ttkpark/BLE_LED_Dongle/BLE_LED_Dongle/placement/BLE_LED_Dongle_BOM.xlsx

Value | Reference | LCSC | Footprint
3.7V | BT1 | C295747 | Connector_JST:JST_PH_S2B-PH-K_1x02_P2.00mm_Horizontal
12p | C1,C2,C3,C4 | C76948 | Capacitor_SMD:C_0402_1005Metric
100n | C5,C8,C9,C15 | C1525 | Capacitor_SMD:C_0402_1005Metric
100p | C6 | C26409 | Capacitor_SMD:C_0402_1005Metric
1u | C7,C12,C14 | C14445 | Capacitor_SMD:C_0402_1005Metric
4u7 | C10 | C23733 | Capacitor_SMD:C_0402_1005Metric
0.8p | C11 | C327032 | Capacitor_SMD:C_0402_1005Metric
22n | C13 | C337699 | Capacitor_SMD:C_0402_1005Metric
47u | C16,C17 | C68361 | Capacitor_SMD:C_1206_3216Metric
WS2812B-2020 | D1,D2,D3,D4,D5,D6,D7,D8,D9,D10,D11,D12,D13,D14,D15,D16,D17,D18,D19,D20,D21,D22,D23,D24,D25,D26,D27,D28,D29,D30,D31,D32,D33,D34,D35,D36,D37,D38,D39,D40,D41,D42,D43,D44,D45,D46,D47,D48,D49,D50,D51,D52,D53,D54,D55,D56,D57,D58,D59,D60,D61,D62,D63,D64,D65,D66,D67,D68,D69,D70,D71,D72,D73,D74,D75,D76,D77,D78,D79,D80,D81,D82,D83,D84,D85,D86,D87,D88,D89,D90,D91,D92,D93,D94,D95,D96,D97,D98,D99,D100,D101,D102,D103,D104,D105,D106,D107,D108,D109,D110,D111,D112,D113,D114,D115,D116,D117,D118,D119,D120,D121,D122,D123,D124,D125,D126,D127,D128,D129,D130,D131,D132,D133,D134,D135,D136,D137,D138,D139,D140,D141,D142,D143,D144 | C965555 | LED_SMD:LED_WS2812B-2020_PLCC4_2.0x2.0mm
Charge | D145 | C19171390 | LED_SMD:LED_0603_1608Metric
Standby | D146 | C22371297 | LED_SMD:LED_0603_1608Metric
Conn_01x04 | J1 | C492412 | Connector_PinHeader_2.54mm:PinHeader_1x04_P2.54mm_Horizontal
Conn_02x08_Counter_Clockwise | J2 |  | Connector_PinHeader_2.54mm:PinHeader_2x08_P2.54mm_Vertical
USB_C_Receptacle_PowerOnly_6P | J3 | C668623 | Connector_USB:USB_C_Receptacle_GCT_USB4125-xx-x-0190_6P_TopMnt_Horizontal
3n9 | L1 | C98062 | Inductor_SMD:L_0402_1005Metric
1u | L2 | C5343973 | Inductor_SMD:L_6.3x6.3_H3
1K5 | R1,R5,R6,R7,R10 | C22843 | Resistor_SMD:R_0603_1608Metric
5K1 | R2,R3 | C23186 | Resistor_SMD:R_0603_1608Metric
11K | R4 | C2906986 | Resistor_SMD:R_0603_1608Metric
SW_SPDT | SW1 | C431547 | SK12D07VG4NSPA_CNK
nRF52810-QCxx | U1 | C519278 | Package_DFN_QFN:QFN-32-1EP_5x5mm_P0.5mm_EP3.6x3.6mm
TPS61023DRLR | U2 | C919459 | DRL0006A
TP4056-42-ESOP8 | U3 | C382139 | Package_SO:SOIC-8-1EP_3.9x4.9mm_P1.27mm_EP2.41x3.3mm_ThermalVias
XC6206PxxxMR | U4 | C5446 | Package_TO_SOT_SMD:SOT-23-3
Crystal | Y1 | C97606 | Crystal:Crystal_SMD_3215-2Pin_3.2x1.5mm
Crystal_GND23 | Y2 | C2965582 | Crystal:Crystal_SMD_2016-4Pin_2.0x1.6mm
