ttkpark/BLE_LED_Dongle/BLE_LED_Dongle/BLE_LED_Dongle.kicad_pcb

## KiCad design BLE_LED_Dongle/BLE_LED_Dongle.kicad_pcb (2026-02-08)

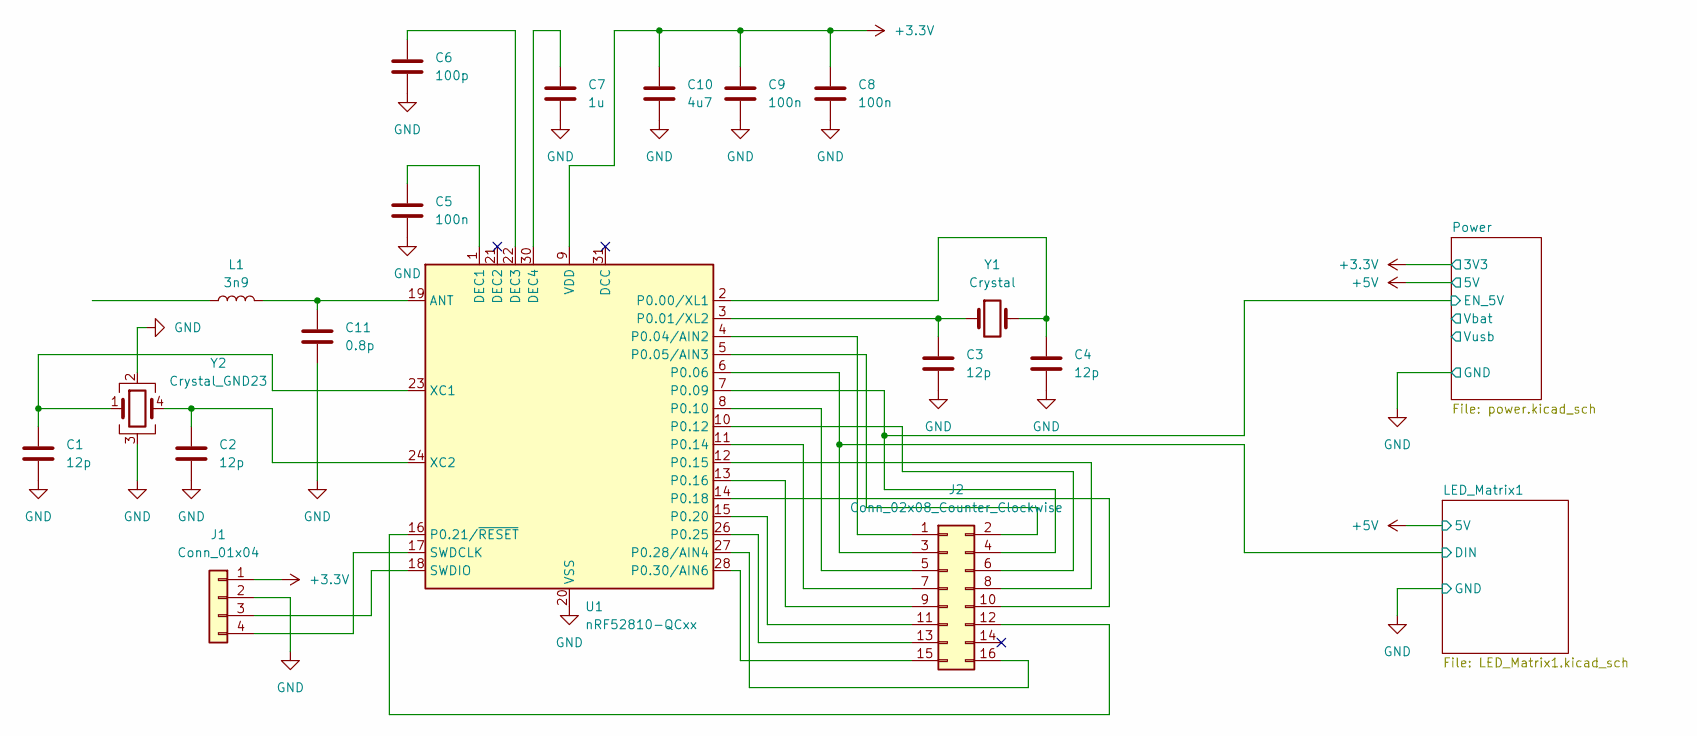
[picture p1: schematic BLE_LED_Dongle.kicad_sch]

Parts:
C1, C2, C3, C4: 12p; C_0402_1005Metric; LCSC C76948
C5, C8, C9: 100n; C_0402_1005Metric; LCSC C1525
C6: 100p; C_0402_1005Metric; LCSC C26409
C7: 1u; C_0402_1005Metric; LCSC C14445
C10: 4u7; C_0402_1005Metric; LCSC C23733
C11: 0.8p; C_0402_1005Metric; LCSC C327032
J1: Conn_01x04; PinHeader_1x04_P2.54mm_Horizontal; LCSC C492412
J2: Conn_02x08_Counter_Clockwise; PinHeader_2x08_P2.54mm_Vertical
L1: 3n9; L_0402_1005Metric; LCSC C98062
U1: nRF52810-QCxx; QFN-32-1EP_5x5mm_P0.5mm_EP3.6x3.6mm; LCSC C519278
Y1: Crystal; Crystal_SMD_3215-2Pin_3.2x1.5mm; LCSC C97606
Y2: Crystal_GND23; Crystal_SMD_2016-4Pin_2.0x1.6mm; LCSC C2965582

Connections:
+3.3V: C8.1, C9.1, C10.1, J1.1, U1.9 (VDD), U1.25 (VDD), U1.32 (VDD); also elsewhere on the board
/LED_Matrix1/DIN: J2.3 (Pin_2), U1.6 (P0.06); also elsewhere on the board
/Power/EN_5V: J2.4 (Pin_15), U1.7 (P0.09); also elsewhere on the board
GND: C1.2, C2.2, C3.2, C4.2, C5.2, C6.2, C7.2, C8.2, C9.2, C10.2, C11.2, J1.2, U1.20 (VSS), U1.29 (VSS), U1.33 (VSS), Y2.2, Y2.3; also elsewhere on the board
unnamed: J1.3, U1.18 (SWDIO)
unnamed: J1.4, U1.17 (SWDCLK)
unnamed: J2.1, U1.4 (P0.04/AIN2)
unnamed: J2.5 (Pin_3), U1.8 (P0.10)
unnamed: J2.7 (Pin_4), U1.11 (P0.14)
unnamed: J2.9 (Pin_5), U1.13 (P0.16)
unnamed: J2.11 (Pin_6), U1.15 (P0.20)
unnamed: J2.13 (Pin_7), U1.26 (P0.25)
unnamed: J2.15 (Pin_8), U1.28 (P0.30/AIN6)
unnamed: J2.12 (Pin_11), U1.16 (P0.21/~RESET)
unnamed: J2.10 (Pin_12), U1.14 (P0.18)
unnamed: J2.8 (Pin_13), U1.12 (P0.15)
unnamed: J2.6 (Pin_14), U1.10 (P0.12)
unnamed: J2.2 (Pin_16), U1.5 (P0.05/AIN3)
unnamed: C11.1, L1.2, U1.19 (ANT)
unnamed: C5.1, U1.1 (DEC1)
unnamed: C6.1, U1.22 (DEC3)
unnamed: C7.1, U1.30 (DEC4)
unnamed: C4.1, U1.2 (P0.00/XL1), Y1.2
unnamed: C3.1, U1.3 (P0.01/XL2), Y1.1
unnamed: J2.16, U1.27 (P0.28/AIN4)
unnamed: C1.1, U1.23 (XC1), Y2.1
unnamed: C2.1, U1.24 (XC2), Y2.4

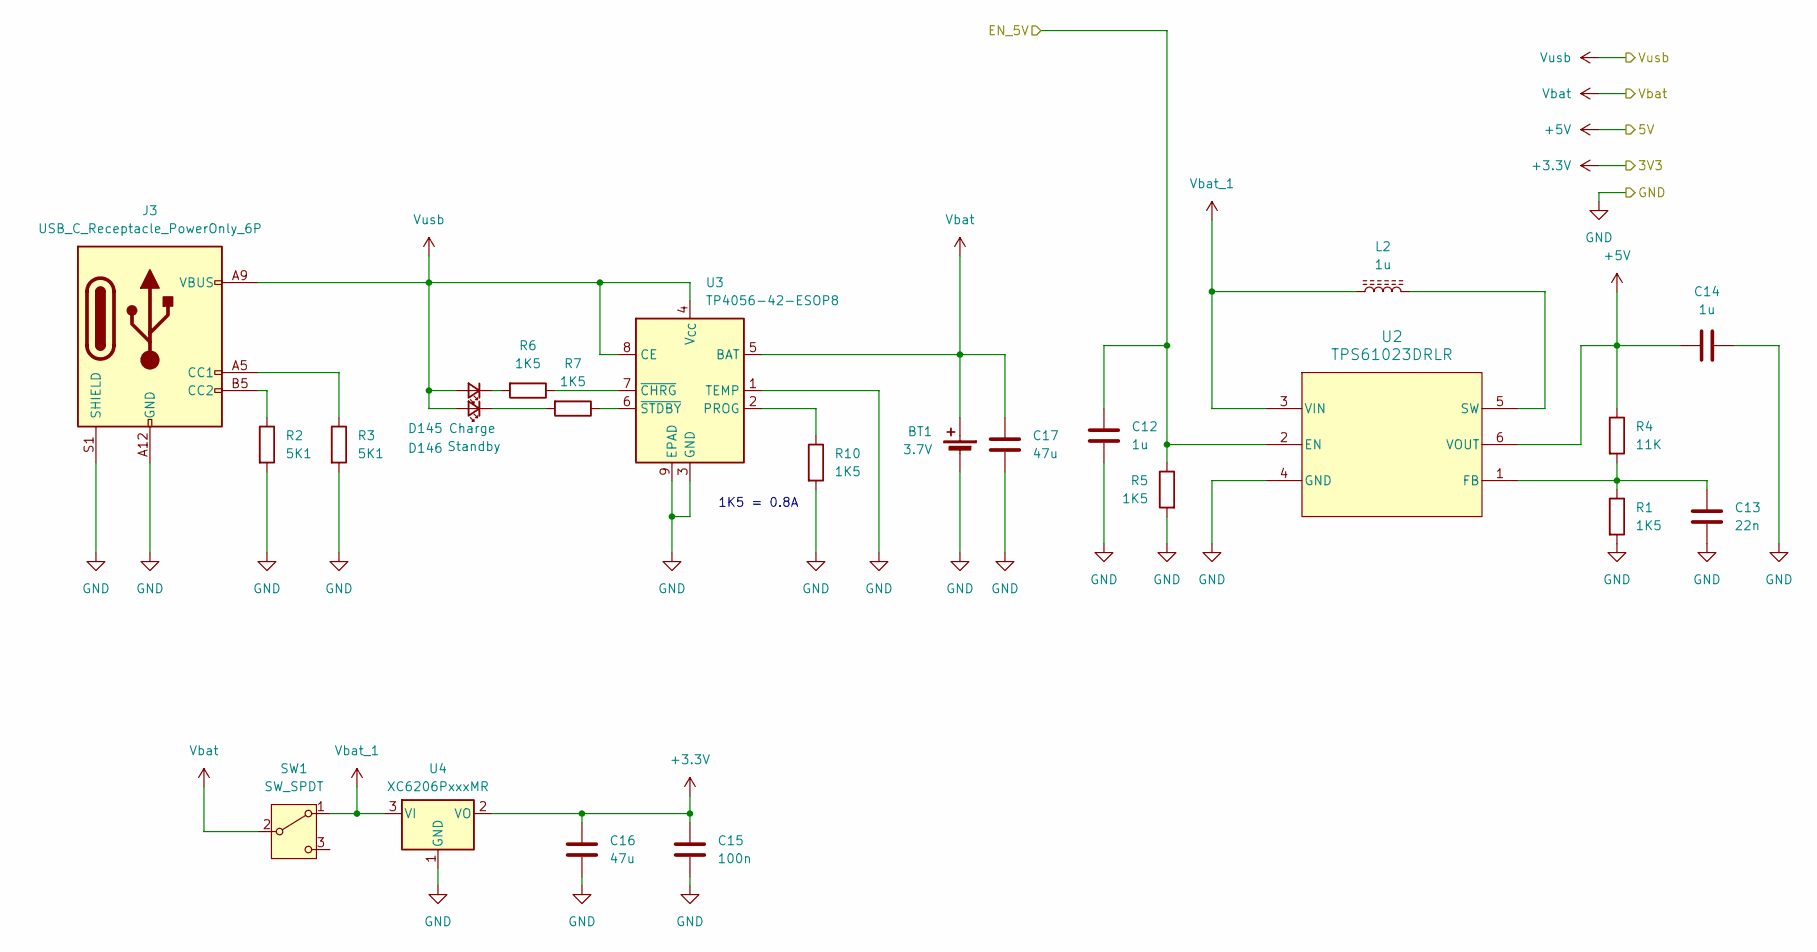
[picture p2: schematic power.kicad_sch]

Parts:
BT1: 3.7V; JST_PH_S2B-PH-K_1x02_P2.00mm_Horizontal; LCSC C295747
C12, C14: 1u; C_0402_1005Metric; LCSC C14445
C13: 22n; C_0402_1005Metric; LCSC C337699
C15: 100n; C_0402_1005Metric; LCSC C1525
C16, C17: 47u; C_1206_3216Metric; LCSC C68361
D145: Charge; LED_0603_1608Metric; LCSC C19171390
D146: Standby; LED_0603_1608Metric; LCSC C22371297
J3: USB_C_Receptacle_PowerOnly_6P; USB_C_Receptacle_GCT_USB4125-xx-x-0190_6P_TopMnt_Horizontal; LCSC C668623
L2: 1u; L_6.3x6.3_H3; LCSC C5343973
R1, R5, R6, R7, R10: 1K5; R_0603_1608Metric; LCSC C22843
R2, R3: 5K1; R_0603_1608Metric; LCSC C23186
R4: 11K; R_0603_1608Metric; LCSC C2906986
SW1: SW_SPDT; SK12D07VG4NSPA_CNK; LCSC C431547
U2: TPS61023DRLR; DRL0006A; LCSC C919459
U3: TP4056-42-ESOP8; SOIC-8-1EP_3.9x4.9mm_P1.27mm_EP2.41x3.3mm_ThermalVias; LCSC C382139
U4: XC6206PxxxMR; SOT-23-3; LCSC C5446

Connections:
+3.3V: C15.2, C16.2, U4.2 (VO); also elsewhere on the board
+5V: C14.1, R4.1, U2.6 (VOUT); also elsewhere on the board
/Power/EN_5V: C12.1, R5.1, U2.2 (EN); also elsewhere on the board
GND: BT1.2 (-), C12.2, C13.2, C14.2, C15.1, C16.1, C17.1, J3.A12 (GND), J3.B12 (GND), J3.S1 (SHIELD), R1.2, R2.2, R3.2, R5.2, R10.2, U2.4 (GND), U3.1 (TEMP), U3.3 (GND), U3.9 (EPAD), U4.1 (GND); also elsewhere on the board
unnamed: D145.1 (K), R6.2
unnamed: D146.1 (K), R7.2
unnamed: J3.A5 (CC1), R3.1
unnamed: J3.B5 (CC2), R2.1
unnamed: C13.1, R1.1, R4.2, U2.1 (FB)
unnamed: L2.2, U2.5 (SW)
unnamed: R10.1, U3.2 (PROG)
unnamed: R6.1, U3.7 (~CHRG)
unnamed: R7.1, U3.6 (~STDBY)
Vbat: BT1.1 (+), C17.2, SW1.2 (B), U3.5 (BAT)
Vbat_1: L2.1, SW1.1 (A), U2.3 (VIN), U4.3 (VI)
Vusb: D145.2 (A), D146.2 (A), J3.A9 (VBUS), J3.B9 (VBUS), U3.4 (V_{CC}), U3.8 (CE)

Notes on the sheet:
1K5 = 0.8A

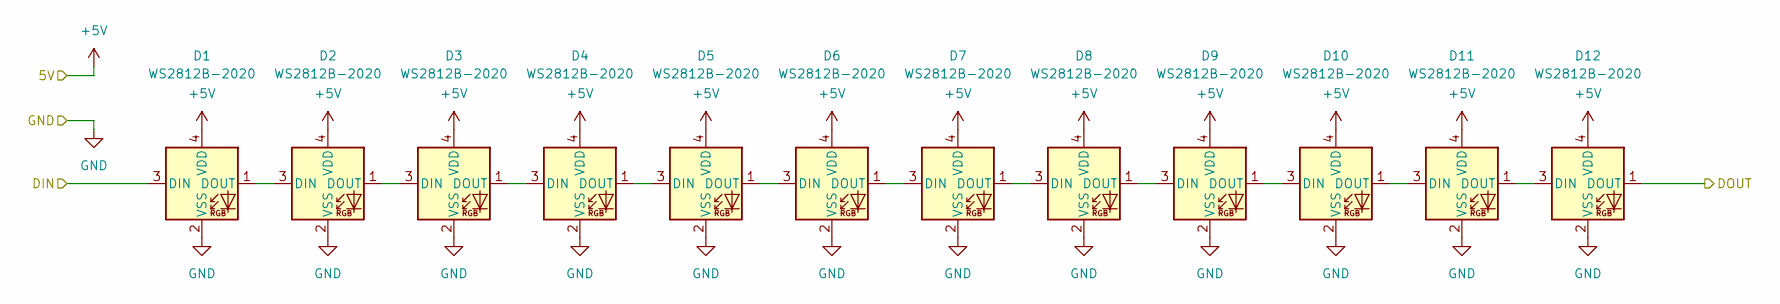
[picture p3: schematic led_matrix.kicad_sch]

Parts:
D1, D2, D3, D4, D5, D6, D7, D8, D9, D10, D11, D12: WS2812B-2020; LED_WS2812B-2020_PLCC4_2.0x2.0mm; LCSC C965555

Connections:
+5V: D1.4 (VDD), D2.4 (VDD), D3.4 (VDD), D4.4 (VDD), D5.4 (VDD), D6.4 (VDD), D7.4 (VDD), D8.4 (VDD), D9.4 (VDD), D10.4 (VDD), D11.4 (VDD), D12.4 (VDD); also elsewhere on the board
/LED_Matrix1/DIN: D1.3 (DIN); also elsewhere on the board
/LED_Matrix1/LED_Matrix_Line0/DOUT: D12.1 (DOUT); also elsewhere on the board
GND: D1.2 (VSS), D2.2 (VSS), D3.2 (VSS), D4.2 (VSS), D5.2 (VSS), D6.2 (VSS), D7.2 (VSS), D8.2 (VSS), D9.2 (VSS), D10.2 (VSS), D11.2 (VSS), D12.2 (VSS); also elsewhere on the board
unnamed: D1.1 (DOUT), D2.3 (DIN)
unnamed: D2.1 (DOUT), D3.3 (DIN)
unnamed: D3.1 (DOUT), D4.3 (DIN)
unnamed: D4.1 (DOUT), D5.3 (DIN)
unnamed: D5.1 (DOUT), D6.3 (DIN)
unnamed: D6.1 (DOUT), D7.3 (DIN)
unnamed: D7.1 (DOUT), D8.3 (DIN)
unnamed: D8.1 (DOUT), D9.3 (DIN)
unnamed: D9.1 (DOUT), D10.3 (DIN)
unnamed: D10.1 (DOUT), D11.3 (DIN)
unnamed: D11.1 (DOUT), D12.3 (DIN)

Parts of its further copies:
D13, D14, D15, D16, D17, D18, D19, D20, D21, D22, D23, D24, D25, D26, D27, D28, D29, D30, D31, D32, D33, D34, D35, D36, D37, D38, D39, D40, D41, D42, D43, D44, D45, D46, D47, D48, D49, D50, D51, D52, D53, D54, D55, D56, D57, D58, D59, D60, D61, D62, D63, D64, D65, D66, D67, D68, D69, D70, D71, D72, D73, D74, D75, D76, D77, D78, D79, D80, D81, D82, D83, D84, D85, D86, D87, D88, D89, D90, D91, D92, D93, D94, D95, D96, D97, D98, D99, D100, D101, D102, D103, D104, D105, D106, D107, D108, D109, D110, D111, D112, D113, D114, D115, D116, D117, D118, D119, D120, D121, D122, D123, D124, D125, D126, D127, D128, D129, D130, D131, D132, D133, D134, D135, D136, D137, D138, D139, D140, D141, D142, D143, D144: WS2812B-2020; LED_WS2812B-2020_PLCC4_2.0x2.0mm; LCSC C965555

Connections of its further copies:
+5V: D13.4 (VDD), D14.4 (VDD), D15.4 (VDD), D16.4 (VDD), D17.4 (VDD), D18.4 (VDD), D19.4 (VDD), D20.4 (VDD), D21.4 (VDD), D22.4 (VDD), D23.4 (VDD), D24.4 (VDD), D25.4 (VDD), D26.4 (VDD), D27.4 (VDD), D28.4 (VDD), D29.4 (VDD), D30.4 (VDD), D31.4 (VDD), D32.4 (VDD), D33.4 (VDD), D34.4 (VDD), D35.4 (VDD), D36.4 (VDD), D37.4 (VDD), D38.4 (VDD), D39.4 (VDD), D40.4 (VDD), D41.4 (VDD), D42.4 (VDD), D43.4 (VDD), D44.4 (VDD), D45.4 (VDD), D46.4 (VDD), D47.4 (VDD), D48.4 (VDD), D49.4 (VDD), D50.4 (VDD), D51.4 (VDD), D52.4 (VDD), D53.4 (VDD), D54.4 (VDD), D55.4 (VDD), D56.4 (VDD), D57.4 (VDD), D58.4 (VDD), D59.4 (VDD), D60.4 (VDD), D61.4 (VDD), D62.4 (VDD), D63.4 (VDD), D64.4 (VDD), D65.4 (VDD), D66.4 (VDD), D67.4 (VDD), D68.4 (VDD), D69.4 (VDD), D70.4 (VDD), D71.4 (VDD), D72.4 (VDD), D73.4 (VDD), D74.4 (VDD), D75.4 (VDD), D76.4 (VDD), D77.4 (VDD), D78.4 (VDD), D79.4 (VDD), D80.4 (VDD), D81.4 (VDD), D82.4 (VDD), D83.4 (VDD), D84.4 (VDD), D85.4 (VDD), D86.4 (VDD), D87.4 (VDD), D88.4 (VDD), D89.4 (VDD), D90.4 (VDD), D91.4 (VDD), D92.4 (VDD), D93.4 (VDD), D94.4 (VDD), D95.4 (VDD), D96.4 (VDD), D97.4 (VDD), D98.4 (VDD), D99.4 (VDD), D100.4 (VDD), D101.4 (VDD), D102.4 (VDD), D103.4 (VDD), D104.4 (VDD), D105.4 (VDD), D106.4 (VDD), D107.4 (VDD), D108.4 (VDD), D109.4 (VDD), D110.4 (VDD), D111.4 (VDD), D112.4 (VDD), D113.4 (VDD), D114.4 (VDD), D115.4 (VDD), D116.4 (VDD), D117.4 (VDD), D118.4 (VDD), D119.4 (VDD), D120.4 (VDD), D121.4 (VDD), D122.4 (VDD), D123.4 (VDD), D124.4 (VDD), D125.4 (VDD), D126.4 (VDD), D127.4 (VDD), D128.4 (VDD), D129.4 (VDD), D130.4 (VDD), D131.4 (VDD), D132.4 (VDD), D133.4 (VDD), D134.4 (VDD), D135.4 (VDD), D136.4 (VDD), D137.4 (VDD), D138.4 (VDD), D139.4 (VDD), D140.4 (VDD), D141.4 (VDD), D142.4 (VDD), D143.4 (VDD), D144.4 (VDD); also elsewhere on the board
/LED_Matrix1/LED_Matrix_Line0/DOUT: D13.3 (DIN); also elsewhere on the board
/LED_Matrix1/LED_Matrix_Line1/DOUT: D24.1 (DOUT), D25.3 (DIN)
/LED_Matrix1/LED_Matrix_Line2/DOUT: D36.1 (DOUT), D37.3 (DIN)
/LED_Matrix1/LED_Matrix_Line3/DOUT: D48.1 (DOUT), D49.3 (DIN)
/LED_Matrix1/LED_Matrix_Line4/DOUT: D60.1 (DOUT), D61.3 (DIN)
/LED_Matrix1/LED_Matrix_Line5/DOUT: D72.1 (DOUT), D73.3 (DIN)
/LED_Matrix1/LED_Matrix_Line6/DOUT: D84.1 (DOUT), D85.3 (DIN)
/LED_Matrix1/LED_Matrix_Line7/DOUT: D96.1 (DOUT), D97.3 (DIN)
/LED_Matrix1/LED_Matrix_Line8/DOUT: D108.1 (DOUT), D109.3 (DIN)
/LED_Matrix1/LED_Matrix_Line10/DIN: D120.1 (DOUT), D121.3 (DIN)
/LED_Matrix1/LED_Matrix_Line10/DOUT: D132.1 (DOUT), D133.3 (DIN)
/LED_Matrix1/LED_Matrix_Line11/DOUT: D144.1 (DOUT)
GND: D13.2 (VSS), D14.2 (VSS), D15.2 (VSS), D16.2 (VSS), D17.2 (VSS), D18.2 (VSS), D19.2 (VSS), D20.2 (VSS), D21.2 (VSS), D22.2 (VSS), D23.2 (VSS), D24.2 (VSS), D25.2 (VSS), D26.2 (VSS), D27.2 (VSS), D28.2 (VSS), D29.2 (VSS), D30.2 (VSS), D31.2 (VSS), D32.2 (VSS), D33.2 (VSS), D34.2 (VSS), D35.2 (VSS), D36.2 (VSS), D37.2 (VSS), D38.2 (VSS), D39.2 (VSS), D40.2 (VSS), D41.2 (VSS), D42.2 (VSS), D43.2 (VSS), D44.2 (VSS), D45.2 (VSS), D46.2 (VSS), D47.2 (VSS), D48.2 (VSS), D49.2 (VSS), D50.2 (VSS), D51.2 (VSS), D52.2 (VSS), D53.2 (VSS), D54.2 (VSS), D55.2 (VSS), D56.2 (VSS), D57.2 (VSS), D58.2 (VSS), D59.2 (VSS), D60.2 (VSS), D61.2 (VSS), D62.2 (VSS), D63.2 (VSS), D64.2 (VSS), D65.2 (VSS), D66.2 (VSS), D67.2 (VSS), D68.2 (VSS), D69.2 (VSS), D70.2 (VSS), D71.2 (VSS), D72.2 (VSS), D73.2 (VSS), D74.2 (VSS), D75.2 (VSS), D76.2 (VSS), D77.2 (VSS), D78.2 (VSS), D79.2 (VSS), D80.2 (VSS), D81.2 (VSS), D82.2 (VSS), D83.2 (VSS), D84.2 (VSS), D85.2 (VSS), D86.2 (VSS), D87.2 (VSS), D88.2 (VSS), D89.2 (VSS), D90.2 (VSS), D91.2 (VSS), D92.2 (VSS), D93.2 (VSS), D94.2 (VSS), D95.2 (VSS), D96.2 (VSS), D97.2 (VSS), D98.2 (VSS), D99.2 (VSS), D100.2 (VSS), D101.2 (VSS), D102.2 (VSS), D103.2 (VSS), D104.2 (VSS), D105.2 (VSS), D106.2 (VSS), D107.2 (VSS), D108.2 (VSS), D109.2 (VSS), D110.2 (VSS), D111.2 (VSS), D112.2 (VSS), D113.2 (VSS), D114.2 (VSS), D115.2 (VSS), D116.2 (VSS), D117.2 (VSS), D118.2 (VSS), D119.2 (VSS), D120.2 (VSS), D121.2 (VSS), D122.2 (VSS), D123.2 (VSS), D124.2 (VSS), D125.2 (VSS), D126.2 (VSS), D127.2 (VSS), D128.2 (VSS), D129.2 (VSS), D130.2 (VSS), D131.2 (VSS), D132.2 (VSS), D133.2 (VSS), D134.2 (VSS), D135.2 (VSS), D136.2 (VSS), D137.2 (VSS), D138.2 (VSS), D139.2 (VSS), D140.2 (VSS), D141.2 (VSS), D142.2 (VSS), D143.2 (VSS), D144.2 (VSS); also elsewhere on the board
unnamed: D13.1 (DOUT), D14.3 (DIN)
unnamed: D14.1 (DOUT), D15.3 (DIN)
unnamed: D15.1 (DOUT), D16.3 (DIN)
unnamed: D16.1 (DOUT), D17.3 (DIN)
unnamed: D17.1 (DOUT), D18.3 (DIN)
unnamed: D18.1 (DOUT), D19.3 (DIN)
unnamed: D19.1 (DOUT), D20.3 (DIN)
unnamed: D20.1 (DOUT), D21.3 (DIN)
unnamed: D21.1 (DOUT), D22.3 (DIN)
unnamed: D22.1 (DOUT), D23.3 (DIN)
unnamed: D23.1 (DOUT), D24.3 (DIN)
unnamed: D25.1 (DOUT), D26.3 (DIN)
unnamed: D26.1 (DOUT), D27.3 (DIN)
unnamed: D27.1 (DOUT), D28.3 (DIN)
unnamed: D28.1 (DOUT), D29.3 (DIN)
unnamed: D29.1 (DOUT), D30.3 (DIN)
unnamed: D30.1 (DOUT), D31.3 (DIN)
unnamed: D31.1 (DOUT), D32.3 (DIN)
unnamed: D32.1 (DOUT), D33.3 (DIN)
unnamed: D33.1 (DOUT), D34.3 (DIN)
unnamed: D34.1 (DOUT), D35.3 (DIN)
unnamed: D35.1 (DOUT), D36.3 (DIN)
unnamed: D37.1 (DOUT), D38.3 (DIN)
unnamed: D38.1 (DOUT), D39.3 (DIN)
unnamed: D39.1 (DOUT), D40.3 (DIN)
unnamed: D40.1 (DOUT), D41.3 (DIN)
unnamed: D41.1 (DOUT), D42.3 (DIN)
unnamed: D42.1 (DOUT), D43.3 (DIN)
unnamed: D43.1 (DOUT), D44.3 (DIN)
unnamed: D44.1 (DOUT), D45.3 (DIN)
unnamed: D45.1 (DOUT), D46.3 (DIN)
unnamed: D46.1 (DOUT), D47.3 (DIN)
unnamed: D47.1 (DOUT), D48.3 (DIN)
unnamed: D49.1 (DOUT), D50.3 (DIN)
unnamed: D50.1 (DOUT), D51.3 (DIN)
unnamed: D51.1 (DOUT), D52.3 (DIN)
unnamed: D52.1 (DOUT), D53.3 (DIN)
unnamed: D53.1 (DOUT), D54.3 (DIN)
unnamed: D54.1 (DOUT), D55.3 (DIN)
unnamed: D55.1 (DOUT), D56.3 (DIN)
unnamed: D56.1 (DOUT), D57.3 (DIN)
unnamed: D57.1 (DOUT), D58.3 (DIN)
unnamed: D58.1 (DOUT), D59.3 (DIN)
unnamed: D59.1 (DOUT), D60.3 (DIN)
unnamed: D61.1 (DOUT), D62.3 (DIN)
unnamed: D62.1 (DOUT), D63.3 (DIN)
unnamed: D63.1 (DOUT), D64.3 (DIN)
unnamed: D64.1 (DOUT), D65.3 (DIN)
unnamed: D65.1 (DOUT), D66.3 (DIN)
unnamed: D66.1 (DOUT), D67.3 (DIN)
unnamed: D67.1 (DOUT), D68.3 (DIN)
unnamed: D68.1 (DOUT), D69.3 (DIN)
unnamed: D69.1 (DOUT), D70.3 (DIN)
unnamed: D70.1 (DOUT), D71.3 (DIN)
unnamed: D71.1 (DOUT), D72.3 (DIN)
unnamed: D73.1 (DOUT), D74.3 (DIN)
unnamed: D74.1 (DOUT), D75.3 (DIN)
unnamed: D75.1 (DOUT), D76.3 (DIN)
unnamed: D76.1 (DOUT), D77.3 (DIN)
unnamed: D77.1 (DOUT), D78.3 (DIN)
unnamed: D78.1 (DOUT), D79.3 (DIN)
unnamed: D79.1 (DOUT), D80.3 (DIN)
unnamed: D80.1 (DOUT), D81.3 (DIN)
unnamed: D81.1 (DOUT), D82.3 (DIN)
unnamed: D82.1 (DOUT), D83.3 (DIN)
unnamed: D83.1 (DOUT), D84.3 (DIN)
unnamed: D85.1 (DOUT), D86.3 (DIN)
unnamed: D86.1 (DOUT), D87.3 (DIN)
unnamed: D87.1 (DOUT), D88.3 (DIN)
unnamed: D88.1 (DOUT), D89.3 (DIN)
unnamed: D89.1 (DOUT), D90.3 (DIN)
unnamed: D90.1 (DOUT), D91.3 (DIN)
unnamed: D91.1 (DOUT), D92.3 (DIN)
unnamed: D92.1 (DOUT), D93.3 (DIN)
unnamed: D93.1 (DOUT), D94.3 (DIN)
unnamed: D94.1 (DOUT), D95.3 (DIN)
unnamed: D95.1 (DOUT), D96.3 (DIN)
unnamed: D97.1 (DOUT), D98.3 (DIN)
unnamed: D98.1 (DOUT), D99.3 (DIN)
unnamed: D99.1 (DOUT), D100.3 (DIN)
unnamed: D100.1 (DOUT), D101.3 (DIN)
unnamed: D101.1 (DOUT), D102.3 (DIN)
unnamed: D102.1 (DOUT), D103.3 (DIN)
unnamed: D103.1 (DOUT), D104.3 (DIN)
unnamed: D104.1 (DOUT), D105.3 (DIN)
unnamed: D105.1 (DOUT), D106.3 (DIN)
unnamed: D106.1 (DOUT), D107.3 (DIN)
unnamed: D107.1 (DOUT), D108.3 (DIN)
unnamed: D109.1 (DOUT), D110.3 (DIN)
unnamed: D110.1 (DOUT), D111.3 (DIN)
unnamed: D111.1 (DOUT), D112.3 (DIN)
unnamed: D112.1 (DOUT), D113.3 (DIN)
unnamed: D113.1 (DOUT), D114.3 (DIN)
unnamed: D114.1 (DOUT), D115.3 (DIN)
unnamed: D115.1 (DOUT), D116.3 (DIN)
unnamed: D116.1 (DOUT), D117.3 (DIN)
unnamed: D117.1 (DOUT), D118.3 (DIN)
unnamed: D118.1 (DOUT), D119.3 (DIN)
unnamed: D119.1 (DOUT), D120.3 (DIN)
unnamed: D121.1 (DOUT), D122.3 (DIN)
unnamed: D122.1 (DOUT), D123.3 (DIN)
unnamed: D123.1 (DOUT), D124.3 (DIN)
unnamed: D124.1 (DOUT), D125.3 (DIN)
unnamed: D125.1 (DOUT), D126.3 (DIN)
unnamed: D126.1 (DOUT), D127.3 (DIN)
unnamed: D127.1 (DOUT), D128.3 (DIN)
unnamed: D128.1 (DOUT), D129.3 (DIN)
unnamed: D129.1 (DOUT), D130.3 (DIN)
unnamed: D130.1 (DOUT), D131.3 (DIN)
unnamed: D131.1 (DOUT), D132.3 (DIN)
unnamed: D133.1 (DOUT), D134.3 (DIN)
unnamed: D134.1 (DOUT), D135.3 (DIN)
unnamed: D135.1 (DOUT), D136.3 (DIN)
unnamed: D136.1 (DOUT), D137.3 (DIN)
unnamed: D137.1 (DOUT), D138.3 (DIN)
unnamed: D138.1 (DOUT), D139.3 (DIN)
unnamed: D139.1 (DOUT), D140.3 (DIN)
unnamed: D140.1 (DOUT), D141.3 (DIN)
unnamed: D141.1 (DOUT), D142.3 (DIN)
unnamed: D142.1 (DOUT), D143.3 (DIN)
unnamed: D143.1 (DOUT), D144.3 (DIN)

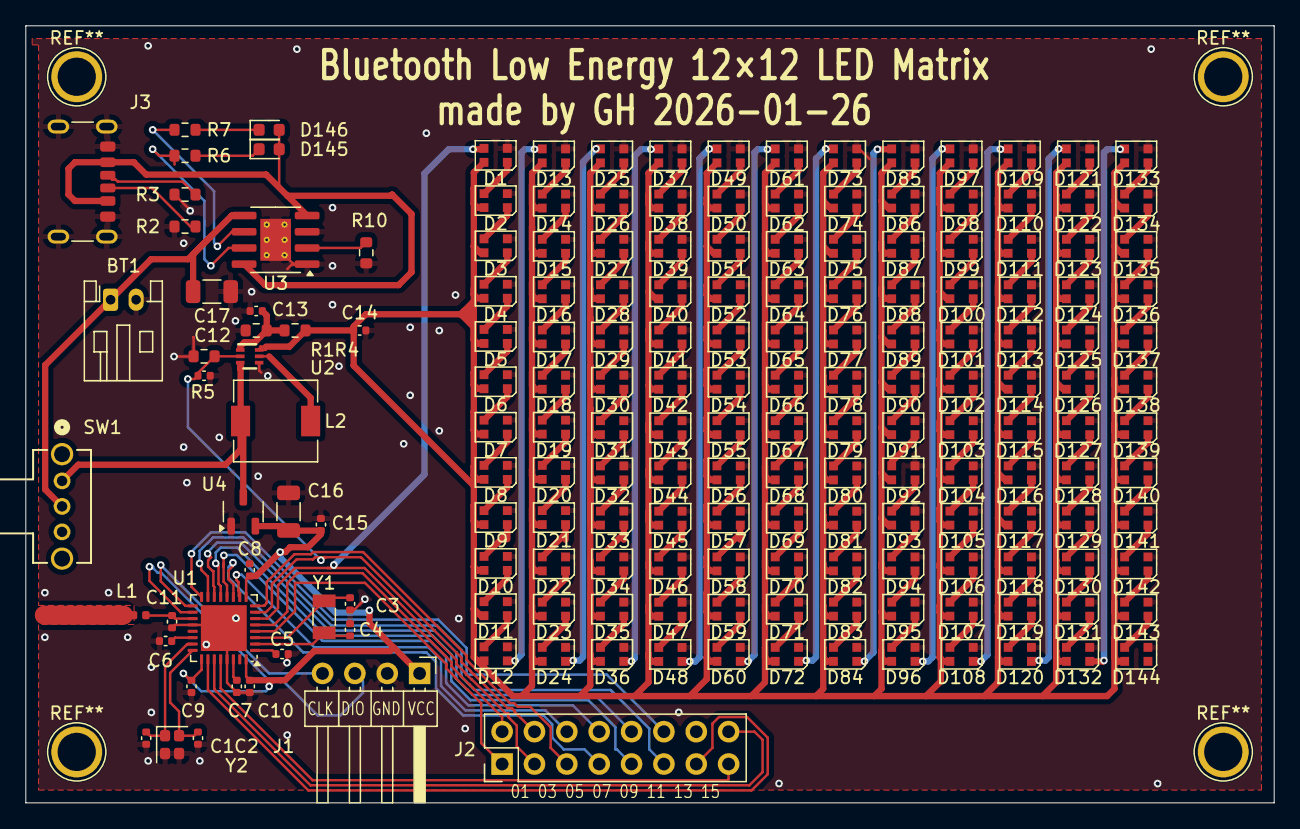
[picture p4: board BLE_LED_Dongle.kicad_pcb from above]

Board: 2 copper layers, 98.0 x 61.0 mm, 184 parts (0 on the bottom side), 183 nets.
