ttkpark/BLE_LED_Dongle/firmware/main.c

/**
 * Copyright (c) 2014 - 2021, Nordic Semiconductor ASA
 *
 * All rights reserved.
 *
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
 * 3. Neither the name of Nordic Semiconductor ASA nor the names of its
 *    contributors may be used to endorse or promote products derived from this
 *    software without specific prior written permission.
 *
 * 4. This software, with or without modification, must only be used with a
 *    Nordic Semiconductor ASA integrated circuit.
 *
 * 5. Any software provided in binary form under this license must not be reverse
 *    engineered, decompiled, modified and/or disassembled.
 *
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
 */
/** @file
 *
 * @defgroup ble_sdk_uart_over_ble_main main.c
 * @{
 * @ingroup  ble_sdk_app_nus_eval
 * @brief    UART over BLE application main file.
 *
 * This file contains the source code for a sample application that uses the Nordic UART service.
 * This application uses the @ref srvlib_conn_params module.
 */


#include <stdint.h>
#include <string.h>
#include "nordic_common.h"
#include "nrf.h"
#include "ble_hci.h"
#include "ble_advdata.h"
#include "ble_advertising.h"
#include "ble_conn_params.h"
#include "nrf_sdh.h"
#include "nrf_sdh_soc.h"
#include "nrf_sdh_ble.h"
#include "nrf_ble_gatt.h"
#include "nrf_ble_qwr.h"
#include "app_timer.h"
#include "ble_nus.h"
// UART disabled - using RTT only
// #include "app_uart.h"
#include "app_util_platform.h"
#include "bsp_btn_ble.h"
#include "nrf_pwr_mgmt.h"


#include <math.h>
#include <stdio.h>
#include "nrf_log.h"
#include "nrf_log_ctrl.h"
#include "nrf_log_default_backends.h"
#include "nrf_gpio.h"
#include "led_matrix.h"
#include "app_timer.h"

#define APP_BLE_CONN_CFG_TAG            1                                           /**< A tag identifying the SoftDevice BLE configuration. */

#define DEVICE_NAME                     "Nordic_UART"                               /**< Name of device. Will be included in the advertising data. */
#define NUS_SERVICE_UUID_TYPE           BLE_UUID_TYPE_VENDOR_BEGIN                  /**< UUID type for the Nordic UART Service (vendor specific). */

#define APP_BLE_OBSERVER_PRIO           3                                           /**< Application's BLE observer priority. You shouldn't need to modify this value. */

#define APP_ADV_INTERVAL                64                                          /**< The advertising interval (in units of 0.625 ms. This value corresponds to 40 ms). */

#define APP_ADV_DURATION                18000                                       /**< The advertising duration (180 seconds) in units of 10 milliseconds. */

#define MIN_CONN_INTERVAL               MSEC_TO_UNITS(20, UNIT_1_25_MS)             /**< Minimum acceptable connection interval (20 ms), Connection interval uses 1.25 ms units. */
#define MAX_CONN_INTERVAL               MSEC_TO_UNITS(75, UNIT_1_25_MS)             /**< Maximum acceptable connection interval (75 ms), Connection interval uses 1.25 ms units. */
#define SLAVE_LATENCY                   0                                           /**< Slave latency. */
#define CONN_SUP_TIMEOUT                MSEC_TO_UNITS(4000, UNIT_10_MS)             /**< Connection supervisory timeout (4 seconds), Supervision Timeout uses 10 ms units. */
#define FIRST_CONN_PARAMS_UPDATE_DELAY  APP_TIMER_TICKS(5000)                       /**< Time from initiating event (connect or start of notification) to first time sd_ble_gap_conn_param_update is called (5 seconds). */
#define NEXT_CONN_PARAMS_UPDATE_DELAY   APP_TIMER_TICKS(30000)                      /**< Time between each call to sd_ble_gap_conn_param_update after the first call (30 seconds). */
#define MAX_CONN_PARAMS_UPDATE_COUNT    3                                           /**< Number of attempts before giving up the connection parameter negotiation. */

#define DEAD_BEEF                       0xDEADBEEF                                  /**< Value used as error code on stack dump, can be used to identify stack location on stack unwind. */

#define UART_TX_BUF_SIZE                256                                         /**< UART TX buffer size. */
#define UART_RX_BUF_SIZE                256                                         /**< UART RX buffer size. */

/** Send LED count over BLE at fixed interval (ms). Timer-based to avoid BLE TX buffer full (NRF_ERROR_RESOURCES). */
#define BLE_SEND_COUNT_INTERVAL_MS      1000

#define LED_UPDATE_INTERVAL_MS    5                                                /**< LED matrix update interval in milliseconds. Slower update to reduce BLE interference. */
APP_TIMER_DEF(m_led_update_timer_id);                                               /**< Timer ID for LED matrix updates. */
APP_TIMER_DEF(m_ble_send_count_timer_id);                                           /**< Timer ID for periodic BLE count send. */
static volatile bool m_led_update_pending = false;                                  /**< Flag indicating LED matrix update is pending. */
static volatile bool m_ble_send_count_pending = false;                              /**< Flag: send LED count over BLE on next idle (set by timer). */
static volatile uint32_t m_led_pattern_counter = 0;                                  /**< Counter for LED pattern animation. */
static volatile bool m_ble_event_processing = false;                                /**< Flag indicating BLE event is being processed. */

/** Callback type for BLE NUS received command. App can parse and handle commands here. */
typedef void (*ble_nus_cmd_callback_t)(const uint8_t * p_data, uint16_t length);
static ble_nus_cmd_callback_t m_ble_nus_cmd_callback = NULL;

/** Register callback for BLE NUS command reception. Pass NULL to disable. */
void ble_nus_set_cmd_callback(ble_nus_cmd_callback_t callback)
{
    m_ble_nus_cmd_callback = callback;
}

/** Forward declaration: send LED matrix count over BLE NUS (defined below). */
uint32_t ble_nus_send_led_matrix_count(uint32_t count);

/**@brief Example command handler: parses received BLE data and handles simple commands.
 *        "get_count" or "count" -> send current LED count over BLE.
 *        Extend this or replace via ble_nus_set_cmd_callback() for more commands.
 */
static void ble_nus_cmd_received(const uint8_t * p_data, uint16_t length)
{
    if (p_data == NULL || length == 0) return;

    /* Trim trailing CR/LF for comparison */
    while (length > 0 && (p_data[length - 1] == '\r' || p_data[length - 1] == '\n'))
        length--;

    if (length == 9 && memcmp(p_data, "get_count", 9) == 0)
    {
        (void)ble_nus_send_led_matrix_count((uint32_t)m_led_pattern_counter);
        NRF_LOG_INFO("RTT: cmd get_count -> sent count %lu", (unsigned long)m_led_pattern_counter);
        NRF_LOG_FLUSH();
        return;
    }
    if (length == 5 && memcmp(p_data, "count", 5) == 0)
    {
        (void)ble_nus_send_led_matrix_count((uint32_t)m_led_pattern_counter);
        NRF_LOG_INFO("RTT: cmd count -> sent count %lu", (unsigned long)m_led_pattern_counter);
        NRF_LOG_FLUSH();
        return;
    }

    NRF_LOG_INFO("RTT: unknown cmd, len=%u", (unsigned)length);
    NRF_LOG_FLUSH();
}

BLE_NUS_DEF(m_nus, NRF_SDH_BLE_TOTAL_LINK_COUNT);                                   /**< BLE NUS service instance. */
NRF_BLE_GATT_DEF(m_gatt);                                                           /**< GATT module instance. */
NRF_BLE_QWR_DEF(m_qwr);                                                             /**< Context for the Queued Write module.*/
BLE_ADVERTISING_DEF(m_advertising);                                                 /**< Advertising module instance. */

static uint16_t   m_conn_handle          = BLE_CONN_HANDLE_INVALID;                 /**< Handle of the current connection. */
static uint16_t   m_ble_nus_max_data_len = BLE_GATT_ATT_MTU_DEFAULT - 3;            /**< Maximum length of data (in bytes) that can be transmitted to the peer by the Nordic UART service module. */
static ble_uuid_t m_adv_uuids[]          =                                          /**< Universally unique service identifier. */
{
    {BLE_UUID_NUS_SERVICE, NUS_SERVICE_UUID_TYPE}
};


/**@brief Function for assert macro callback.
 *
 * @details This function will be called in case of an assert in the SoftDevice.
 *
 * @warning This handler is an example only and does not fit a final product. You need to analyse
 *          how your product is supposed to react in case of Assert.
 * @warning On assert from the SoftDevice, the system can only recover on reset.
 *
 * @param[in] line_num    Line number of the failing ASSERT call.
 * @param[in] p_file_name File name of the failing ASSERT call.
 */
void assert_nrf_callback(uint16_t line_num, const uint8_t * p_file_name)
{
    app_error_handler(DEAD_BEEF, line_num, p_file_name);
}

/**@brief Timer handler for LED matrix updates.
 *
 * @details This function is called periodically to request LED matrix update.
 *          It only sets a flag - actual LED update happens in main loop to avoid
 *          interrupting SoftDevice during critical operations.
 */
static void led_update_timer_handler(void * p_context)
{
    (void)p_context;
    m_led_update_pending = true;
    m_led_pattern_counter++;
}

/**@brief Timer handler: request one BLE count send on next idle. Keeps send interval regular (avoids NRF_ERROR_RESOURCES). */
static void ble_send_count_timer_handler(void * p_context)
{
    (void)p_context;
    m_ble_send_count_pending = true;
}

/**@brief Function for initializing the timer module.
 */
static void timers_init(void)
{
    ret_code_t err_code = app_timer_init();
    APP_ERROR_CHECK(err_code);
    
    err_code = app_timer_create(&m_led_update_timer_id,
                                 APP_TIMER_MODE_REPEATED,
                                 led_update_timer_handler);
    APP_ERROR_CHECK(err_code);

    err_code = app_timer_create(&m_ble_send_count_timer_id,
                                 APP_TIMER_MODE_REPEATED,
                                 ble_send_count_timer_handler);
    APP_ERROR_CHECK(err_code);
}

/**@brief Function for the GAP initialization.
 *
 * @details This function will set up all the necessary GAP (Generic Access Profile) parameters of
 *          the device. It also sets the permissions and appearance.
 */
static void gap_params_init(void)
{
    uint32_t                err_code;
    ble_gap_conn_params_t   gap_conn_params;
    ble_gap_conn_sec_mode_t sec_mode;

    BLE_GAP_CONN_SEC_MODE_SET_OPEN(&sec_mode);

    err_code = sd_ble_gap_device_name_set(&sec_mode,
                                          (const uint8_t *) DEVICE_NAME,
                                          strlen(DEVICE_NAME));
    APP_ERROR_CHECK(err_code);

    memset(&gap_conn_params, 0, sizeof(gap_conn_params));

    gap_conn_params.min_conn_interval = MIN_CONN_INTERVAL;
    gap_conn_params.max_conn_interval = MAX_CONN_INTERVAL;
    gap_conn_params.slave_latency     = SLAVE_LATENCY;
    gap_conn_params.conn_sup_timeout  = CONN_SUP_TIMEOUT;

    err_code = sd_ble_gap_ppcp_set(&gap_conn_params);
    APP_ERROR_CHECK(err_code);
}


/**@brief Function for handling Queued Write Module errors.
 *
 * @details A pointer to this function will be passed to each service which may need to inform the
 *          application about an error.
 *
 * @param[in]   nrf_error   Error code containing information about what went wrong.
 */
static void nrf_qwr_error_handler(uint32_t nrf_error)
{
    APP_ERROR_HANDLER(nrf_error);
}


/**@brief Send LED matrix count over BLE NUS (GATT). Also logs to RTT.
 *         Call when connected; no-op if disconnected.
 * @param[in] count  LED pattern counter value to send.
 * @return NRF_SUCCESS on success, or BLE error code.
 */
uint32_t ble_nus_send_led_matrix_count(uint32_t count)
{
    if (m_conn_handle == BLE_CONN_HANDLE_INVALID)
    {
        return NRF_ERROR_INVALID_STATE;
    }

    static uint8_t tx_buf[32];
    int len = snprintf((char *)tx_buf, sizeof(tx_buf), "count:%lu\r\n", (unsigned long)count);
    if (len <= 0 || (size_t)len >= sizeof(tx_buf))
    {
        return NRF_ERROR_DATA_SIZE;
    }

    uint16_t length = (uint16_t)len;
    ret_code_t err_code = ble_nus_data_send(&m_nus, tx_buf, &length, m_conn_handle);

    NRF_LOG_INFO("BLE TX [RTT]: count=%lu, len=%u, err=0x%x", (unsigned long)count, (unsigned)length, err_code);
    NRF_LOG_FLUSH();

    return err_code;
}


/**@brief Function for handling the data from the Nordic UART Service.
 *
 * @details This function will process the data received from the Nordic UART BLE Service,
 *          log to RTT, and invoke the command callback for application handling.
 *
 * @param[in] p_evt       Nordic UART Service event.
 */
/**@snippet [Handling the data received over BLE] */
static void nus_data_handler(ble_nus_evt_t * p_evt)
{
    if (p_evt->type == BLE_NUS_EVT_RX_DATA)
    {
        const uint8_t * p_data = p_evt->params.rx_data.p_data;
        uint16_t length = p_evt->params.rx_data.length;

        NRF_LOG_INFO("BLE RX [RTT]: len=%u", (unsigned)length);
        NRF_LOG_HEXDUMP_DEBUG(p_data, length);
        NRF_LOG_FLUSH();

        if (m_ble_nus_cmd_callback != NULL)
        {
            m_ble_nus_cmd_callback(p_data, length);
        }
    }
}
/**@snippet [Handling the data received over BLE] */


/**@brief Function for initializing services that will be used by the application.
 */
static void services_init(void)
{
    uint32_t           err_code;
    ble_nus_init_t     nus_init;
    nrf_ble_qwr_init_t qwr_init = {0};

    // Initialize Queued Write Module.
    qwr_init.error_handler = nrf_qwr_error_handler;

    err_code = nrf_ble_qwr_init(&m_qwr, &qwr_init);
    APP_ERROR_CHECK(err_code);

    // Initialize NUS.
    memset(&nus_init, 0, sizeof(nus_init));

    nus_init.data_handler = nus_data_handler;

    err_code = ble_nus_init(&m_nus, &nus_init);
    APP_ERROR_CHECK(err_code);

    ble_nus_set_cmd_callback(ble_nus_cmd_received);
}


/**@brief Function for handling an event from the Connection Parameters Module.
 *
 * @details This function will be called for all events in the Connection Parameters Module
 *          which are passed to the application.
 *
 * @note All this function does is to disconnect. This could have been done by simply setting
 *       the disconnect_on_fail config parameter, but instead we use the event handler
 *       mechanism to demonstrate its use.
 *
 * @param[in] p_evt  Event received from the Connection Parameters Module.
 */
static void on_conn_params_evt(ble_conn_params_evt_t * p_evt)
{
    uint32_t err_code;

    if (p_evt->evt_type == BLE_CONN_PARAMS_EVT_FAILED)
    {
        err_code = sd_ble_gap_disconnect(m_conn_handle, BLE_HCI_CONN_INTERVAL_UNACCEPTABLE);
        APP_ERROR_CHECK(err_code);
    }
}


/**@brief Function for handling errors from the Connection Parameters module.
 *
 * @param[in] nrf_error  Error code containing information about what went wrong.
 */
static void conn_params_error_handler(uint32_t nrf_error)
{
    APP_ERROR_HANDLER(nrf_error);
}


/**@brief Function for initializing the Connection Parameters module.
 */
static void conn_params_init(void)
{
    uint32_t               err_code;
    ble_conn_params_init_t cp_init;

    memset(&cp_init, 0, sizeof(cp_init));

    cp_init.p_conn_params                  = NULL;
    cp_init.first_conn_params_update_delay = FIRST_CONN_PARAMS_UPDATE_DELAY;
    cp_init.next_conn_params_update_delay  = NEXT_CONN_PARAMS_UPDATE_DELAY;
    cp_init.max_conn_params_update_count   = MAX_CONN_PARAMS_UPDATE_COUNT;
    cp_init.start_on_notify_cccd_handle    = BLE_GATT_HANDLE_INVALID;
    cp_init.disconnect_on_fail             = false;
    cp_init.evt_handler                    = on_conn_params_evt;
    cp_init.error_handler                  = conn_params_error_handler;

    err_code = ble_conn_params_init(&cp_init);
    APP_ERROR_CHECK(err_code);
}


/**@brief Function for putting the chip into sleep mode.
 *
 * @note This function will not return.
 */
static void sleep_mode_enter(void)
{
    uint32_t err_code = bsp_indication_set(BSP_INDICATE_IDLE);
    APP_ERROR_CHECK(err_code);

    // Prepare wakeup buttons.
    err_code = bsp_btn_ble_sleep_mode_prepare();
    APP_ERROR_CHECK(err_code);

    // Go to system-off mode (this function will not return; wakeup will cause a reset).
    err_code = sd_power_system_off();
    APP_ERROR_CHECK(err_code);
}


/**@brief Function for handling advertising events.
 *
 * @details This function will be called for advertising events which are passed to the application.
 *
 * @param[in] ble_adv_evt  Advertising event.
 */
static void on_adv_evt(ble_adv_evt_t ble_adv_evt)
{
    uint32_t err_code;

    switch (ble_adv_evt)
    {
        case BLE_ADV_EVT_FAST:
            NRF_LOG_INFO("BLE_ADV_EVT_FAST: Fast advertising started");
            NRF_LOG_FLUSH();
            
            // Set TX power to maximum for better range and discoverability
            // This must be done after advertising starts, when handle is available
            err_code = sd_ble_gap_tx_power_set(BLE_GAP_TX_POWER_ROLE_ADV, m_advertising.adv_handle, 4);
            if (err_code != NRF_SUCCESS)
            {
                NRF_LOG_ERROR("sd_ble_gap_tx_power_set failed: 0x%08X", err_code);
                NRF_LOG_FLUSH();
            }
            else
            {
                NRF_LOG_INFO("TX power set to +4dBm (handle: %d)", m_advertising.adv_handle);
                NRF_LOG_FLUSH();
            }
            
            err_code = bsp_indication_set(BSP_INDICATE_ADVERTISING);
            APP_ERROR_CHECK(err_code);
            break;
        case BLE_ADV_EVT_SLOW:
            NRF_LOG_INFO("BLE_ADV_EVT_SLOW: Slow advertising started");
            NRF_LOG_FLUSH();
            
            // Set TX power to maximum for better range and discoverability
            // This must be done after advertising starts, when handle is available
            err_code = sd_ble_gap_tx_power_set(BLE_GAP_TX_POWER_ROLE_ADV, m_advertising.adv_handle, 4);
            if (err_code != NRF_SUCCESS)
            {
                NRF_LOG_ERROR("sd_ble_gap_tx_power_set failed: 0x%08X", err_code);
                NRF_LOG_FLUSH();
            }
            else
            {
                NRF_LOG_INFO("TX power set to +4dBm (handle: %d)", m_advertising.adv_handle);
                NRF_LOG_FLUSH();
            }
            
            err_code = bsp_indication_set(BSP_INDICATE_ADVERTISING);
            APP_ERROR_CHECK(err_code);
            break;
        case BLE_ADV_EVT_IDLE:
            NRF_LOG_INFO("BLE_ADV_EVT_IDLE: Advertising stopped");
            NRF_LOG_FLUSH();
            // Don't enter sleep mode here - ble_advertising module will automatically
            // restart advertising in the next mode (slow advertising)
            // sleep_mode_enter() should only be called when user explicitly requests it
            break;
        default:
            NRF_LOG_INFO("BLE advertising event: %d", ble_adv_evt);
            NRF_LOG_FLUSH();
            break;
    }
}


/**@brief Function for handling BLE events.
 *
 * @param[in]   p_ble_evt   Bluetooth stack event.
 * @param[in]   p_context   Unused.
 */
static void ble_evt_handler(ble_evt_t const * p_ble_evt, void * p_context)
{
    uint32_t err_code;
    
    // Set flag to indicate BLE event is being processed
    // LED updates will be deferred during BLE event processing
    m_ble_event_processing = true;

    switch (p_ble_evt->header.evt_id)
    {
        case BLE_GAP_EVT_CONNECTED:
            NRF_LOG_INFO("Connected");
            err_code = bsp_indication_set(BSP_INDICATE_CONNECTED);
            APP_ERROR_CHECK(err_code);
            m_conn_handle = p_ble_evt->evt.gap_evt.conn_handle;
            err_code = nrf_ble_qwr_conn_handle_assign(&m_qwr, m_conn_handle);
            APP_ERROR_CHECK(err_code);
            break;

        case BLE_GAP_EVT_DISCONNECTED:
            NRF_LOG_INFO("Disconnected");
            // LED indication will be changed when advertising starts.
            m_conn_handle = BLE_CONN_HANDLE_INVALID;
            break;

        case BLE_GAP_EVT_PHY_UPDATE_REQUEST:
        {
            NRF_LOG_DEBUG("PHY update request.");
            ble_gap_phys_t const phys =
            {
                .rx_phys = BLE_GAP_PHY_AUTO,
                .tx_phys = BLE_GAP_PHY_AUTO,
            };
            err_code = sd_ble_gap_phy_update(p_ble_evt->evt.gap_evt.conn_handle, &phys);
            APP_ERROR_CHECK(err_code);
        } break;

        case BLE_GAP_EVT_SEC_PARAMS_REQUEST:
            // Pairing not supported
            err_code = sd_ble_gap_sec_params_reply(m_conn_handle, BLE_GAP_SEC_STATUS_PAIRING_NOT_SUPP, NULL, NULL);
            APP_ERROR_CHECK(err_code);
            break;

        case BLE_GATTS_EVT_SYS_ATTR_MISSING:
            // No system attributes have been stored.
            err_code = sd_ble_gatts_sys_attr_set(m_conn_handle, NULL, 0, 0);
            APP_ERROR_CHECK(err_code);
            break;

        case BLE_GATTC_EVT_TIMEOUT:
            // Disconnect on GATT Client timeout event.
            err_code = sd_ble_gap_disconnect(p_ble_evt->evt.gattc_evt.conn_handle,
                                             BLE_HCI_REMOTE_USER_TERMINATED_CONNECTION);
            APP_ERROR_CHECK(err_code);
            break;

        case BLE_GATTS_EVT_TIMEOUT:
            // Disconnect on GATT Server timeout event.
            err_code = sd_ble_gap_disconnect(p_ble_evt->evt.gatts_evt.conn_handle,
                                             BLE_HCI_REMOTE_USER_TERMINATED_CONNECTION);
            APP_ERROR_CHECK(err_code);
            break;

        default:
            // No implementation needed.
            break;
    }
    
    // Clear flag after BLE event processing is complete
    m_ble_event_processing = false;
}


/**@brief Function for the SoftDevice initialization.
 *
 * @details This function initializes the SoftDevice and the BLE event interrupt.
 */
static void ble_stack_init(void)
{
    ret_code_t err_code;

    NRF_LOG_INFO("Initializing SoftDevice...");
    NRF_LOG_FLUSH();
    err_code = nrf_sdh_enable_request();
    if (err_code != NRF_SUCCESS)
    {
        NRF_LOG_ERROR("nrf_sdh_enable_request failed: 0x%08X", err_code);
        NRF_LOG_FLUSH();
    }
    APP_ERROR_CHECK(err_code);

    // Configure the BLE stack using the default settings.
    // Fetch the start address of the application RAM.
    uint32_t ram_start = 0;
    NRF_LOG_INFO("Configuring BLE stack...");
    NRF_LOG_FLUSH();
    err_code = nrf_sdh_ble_default_cfg_set(APP_BLE_CONN_CFG_TAG, &ram_start);
    if (err_code != NRF_SUCCESS)
    {
        NRF_LOG_ERROR("nrf_sdh_ble_default_cfg_set failed: 0x%08X", err_code);
        NRF_LOG_FLUSH();
    }
    APP_ERROR_CHECK(err_code);

    // Enable BLE stack.
    NRF_LOG_INFO("Enabling BLE stack...");
    NRF_LOG_FLUSH();
    err_code = nrf_sdh_ble_enable(&ram_start);
    if (err_code != NRF_SUCCESS)
    {
        NRF_LOG_ERROR("nrf_sdh_ble_enable failed: 0x%08X", err_code);
        NRF_LOG_FLUSH();
    }
    APP_ERROR_CHECK(err_code);

    // Register a handler for BLE events.
    NRF_SDH_BLE_OBSERVER(m_ble_observer, APP_BLE_OBSERVER_PRIO, ble_evt_handler, NULL);
    
    NRF_LOG_INFO("BLE stack initialized successfully");
    NRF_LOG_FLUSH();
}


/**@brief Function for handling events from the GATT library. */
void gatt_evt_handler(nrf_ble_gatt_t * p_gatt, nrf_ble_gatt_evt_t const * p_evt)
{
    if ((m_conn_handle == p_evt->conn_handle) && (p_evt->evt_id == NRF_BLE_GATT_EVT_ATT_MTU_UPDATED))
    {
        m_ble_nus_max_data_len = p_evt->params.att_mtu_effective - OPCODE_LENGTH - HANDLE_LENGTH;
        NRF_LOG_INFO("Data len is set to 0x%X(%d)", m_ble_nus_max_data_len, m_ble_nus_max_data_len);
    }
    NRF_LOG_DEBUG("ATT MTU exchange completed. central 0x%x peripheral 0x%x",
                  p_gatt->att_mtu_desired_central,
                  p_gatt->att_mtu_desired_periph);
}


/**@brief Function for initializing the GATT library. */
void gatt_init(void)
{
    ret_code_t err_code;

    err_code = nrf_ble_gatt_init(&m_gatt, gatt_evt_handler);
    APP_ERROR_CHECK(err_code);

    err_code = nrf_ble_gatt_att_mtu_periph_set(&m_gatt, NRF_SDH_BLE_GATT_MAX_MTU_SIZE);
    APP_ERROR_CHECK(err_code);
}


/**@brief Function for handling events from the BSP module.
 *
 * @param[in]   event   Event generated by button press.
 */
void bsp_event_handler(bsp_event_t event)
{
    uint32_t err_code;
    switch (event)
    {
        case BSP_EVENT_SLEEP:
            sleep_mode_enter();
            break;

        case BSP_EVENT_DISCONNECT:
            err_code = sd_ble_gap_disconnect(m_conn_handle, BLE_HCI_REMOTE_USER_TERMINATED_CONNECTION);
            if (err_code != NRF_ERROR_INVALID_STATE)
            {
                APP_ERROR_CHECK(err_code);
            }
            break;

        case BSP_EVENT_WHITELIST_OFF:
            if (m_conn_handle == BLE_CONN_HANDLE_INVALID)
            {
                err_code = ble_advertising_restart_without_whitelist(&m_advertising);
                if (err_code != NRF_ERROR_INVALID_STATE)
                {
                    APP_ERROR_CHECK(err_code);
                }
            }
            break;

        default:
            break;
    }
}


/**@brief   Function for handling app_uart events.
 *
 * @details This function will receive a single character from the app_uart module and append it to
 *          a string. The string will be be sent over BLE when the last character received was a
 *          'new line' '\n' (hex 0x0A) or if the string has reached the maximum data length.
 */
/**@snippet [Handling the data received over UART] */
// UART disabled - using RTT only
#if 0
void uart_event_handle(app_uart_evt_t * p_event)
{
    static uint8_t data_array[BLE_NUS_MAX_DATA_LEN];
    static uint8_t index = 0;
    uint32_t       err_code;

    switch (p_event->evt_type)
    {
        case APP_UART_DATA_READY:
            UNUSED_VARIABLE(app_uart_get(&data_array[index]));
            index++;

            if ((data_array[index - 1] == '\n') ||
                (data_array[index - 1] == '\r') ||
                (index >= m_ble_nus_max_data_len))
            {
                if (index > 1)
                {
                    NRF_LOG_DEBUG("Ready to send data over BLE NUS");
                    NRF_LOG_HEXDUMP_DEBUG(data_array, index);

                    do
                    {
                        uint16_t length = (uint16_t)index;
                        err_code = ble_nus_data_send(&m_nus, data_array, &length, m_conn_handle);
                        if ((err_code != NRF_ERROR_INVALID_STATE) &&
                            (err_code != NRF_ERROR_RESOURCES) &&
                            (err_code != NRF_ERROR_NOT_FOUND))
                        {
                            APP_ERROR_CHECK(err_code);
                        }
                    } while (err_code == NRF_ERROR_RESOURCES);
                }

                index = 0;
            }
            break;

        case APP_UART_COMMUNICATION_ERROR:
            APP_ERROR_HANDLER(p_event->data.error_communication);
            break;

        case APP_UART_FIFO_ERROR:
            APP_ERROR_HANDLER(p_event->data.error_code);
            break;

        default:
            break;
    }
}
#endif
/**@snippet [Handling the data received over UART] */


/**@brief  Function for initializing the UART module.
 */
/**@snippet [UART Initialization] */
// UART disabled - using RTT only
#if 0
static void uart_init(void)
{
    uint32_t                     err_code;
    app_uart_comm_params_t const comm_params =
    {
        .rx_pin_no    = RX_PIN_NUMBER,
        .tx_pin_no    = TX_PIN_NUMBER,
        .rts_pin_no   = RTS_PIN_NUMBER,
        .cts_pin_no   = CTS_PIN_NUMBER,
        .flow_control = APP_UART_FLOW_CONTROL_DISABLED,
        .use_parity   = false,
#if defined (UART_PRESENT)
        .baud_rate    = NRF_UART_BAUDRATE_115200
#else
        .baud_rate    = NRF_UARTE_BAUDRATE_115200
#endif
    };

    APP_UART_FIFO_INIT(&comm_params,
                       UART_RX_BUF_SIZE,
                       UART_TX_BUF_SIZE,
                       uart_event_handle,
                       APP_IRQ_PRIORITY_LOWEST,
                       err_code);
    APP_ERROR_CHECK(err_code);
}
#endif
/**@snippet [UART Initialization] */


/**@brief Function for initializing the Advertising functionality.
 */
static void advertising_init(void)
{
    uint32_t               err_code;
    ble_advertising_init_t init;

    memset(&init, 0, sizeof(init));

    init.advdata.name_type          = BLE_ADVDATA_FULL_NAME;
    init.advdata.include_appearance = false;
    init.advdata.flags              = BLE_GAP_ADV_FLAGS_LE_ONLY_GENERAL_DISC_MODE;

    init.srdata.uuids_complete.uuid_cnt = sizeof(m_adv_uuids) / sizeof(m_adv_uuids[0]);
    init.srdata.uuids_complete.p_uuids  = m_adv_uuids;

    init.config.ble_adv_fast_enabled  = true;
    init.config.ble_adv_fast_interval = APP_ADV_INTERVAL;
    init.config.ble_adv_fast_timeout  = APP_ADV_DURATION;
    init.config.ble_adv_slow_enabled  = true;
    init.config.ble_adv_slow_interval = APP_ADV_INTERVAL;  // Same interval as fast for better discoverability
    init.config.ble_adv_slow_timeout  = 0;  // 0 = no timeout, advertise indefinitely
    init.evt_handler = on_adv_evt;

    NRF_LOG_INFO("Initializing BLE advertising...");
    NRF_LOG_FLUSH();
    err_code = ble_advertising_init(&m_advertising, &init);
    if (err_code != NRF_SUCCESS)
    {
        NRF_LOG_ERROR("ble_advertising_init failed: 0x%08X", err_code);
        NRF_LOG_FLUSH();
    }
    APP_ERROR_CHECK(err_code);

    ble_advertising_conn_cfg_tag_set(&m_advertising, APP_BLE_CONN_CFG_TAG);
    NRF_LOG_INFO("BLE advertising initialized successfully");
    NRF_LOG_FLUSH();
}


/**@brief Function for initializing buttons and leds.
 *
 * @param[out] p_erase_bonds  Will be true if the clear bonding button was pressed to wake the application up.
 */
static void buttons_leds_init(bool * p_erase_bonds)
{
    bsp_event_t startup_event;

    uint32_t err_code = bsp_init(BSP_INIT_LEDS | BSP_INIT_BUTTONS, bsp_event_handler);
    APP_ERROR_CHECK(err_code);

    err_code = bsp_btn_ble_init(NULL, &startup_event);
    APP_ERROR_CHECK(err_code);

    *p_erase_bonds = (startup_event == BSP_EVENT_CLEAR_BONDING_DATA);
}


/**@brief Function for initializing the nrf log module.
 */
static void log_init(void)
{
    ret_code_t err_code = NRF_LOG_INIT(NULL);
    APP_ERROR_CHECK(err_code);

    NRF_LOG_DEFAULT_BACKENDS_INIT();
}


/**@brief Function for initializing power management.
 */
static void power_management_init(void)
{
    ret_code_t err_code;
    err_code = nrf_pwr_mgmt_init();
    APP_ERROR_CHECK(err_code);
}


/**@brief Function for handling the idle state (main loop).
 *
 * @details If there is no pending log operation, then sleep until next the next event occurs.
 *          Also handles LED matrix updates when requested by timer, but only when it's safe
 *          (BLE is not processing events and SoftDevice is not suspended).
 */
static void idle_state_handle(void)
{
    // Handle LED matrix update if pending (memory only - safe with SoftDevice)
    if (m_led_update_pending && !m_ble_event_processing)
    {
        if (nrf_sdh_is_enabled() && !nrf_sdh_is_suspended())
        {
            m_led_update_pending = false;
            //matrix_rainbow((uint8_t)m_led_pattern_counter);
            m_led_pattern_counter;
            
            float amp = 4.2f;
            float phi = M_PI*2/3;
            for (uint16_t i = 0; i < MATRIX_N; i++){
                float phase = M_PI*2*((m_led_pattern_counter%500)/500.f + (i/12)/12.f + (i%12)/12.f);
                matrix_set_pixel((uint8_t)(i / MATRIX_W), (uint8_t)(i % MATRIX_W), amp*(sin(phase)+1.f), amp*(sin(phase+phi)+1.f), amp*(sin(phase+phi*2)+1.f));
            }

            matrix_show();

            /* Send LED count over BLE at fixed interval (timer-driven) to avoid NRF_ERROR_RESOURCES. */
            if (m_ble_send_count_pending && m_conn_handle != BLE_CONN_HANDLE_INVALID)
            {
                m_ble_send_count_pending = false;
                (void)ble_nus_send_led_matrix_count((uint32_t)m_led_pattern_counter);
            }
        }
    }

    if (NRF_LOG_PROCESS() == false)
    {
        nrf_pwr_mgmt_run();
    }
}


/**@brief Function for starting advertising.
 */
static void advertising_start(void)
{
    NRF_LOG_INFO("Starting BLE advertising...");
    NRF_LOG_FLUSH();
    uint32_t err_code = ble_advertising_start(&m_advertising, BLE_ADV_MODE_FAST);
    if (err_code != NRF_SUCCESS)
    {
        NRF_LOG_ERROR("ble_advertising_start failed: 0x%08X", err_code);
        NRF_LOG_FLUSH();
    }
    APP_ERROR_CHECK(err_code);
    NRF_LOG_INFO("BLE advertising started");
    NRF_LOG_FLUSH();
}


/**@brief Application main function.
 */
int main(void)

{
    bool erase_bonds;

    // Initialize.
    // uart_init();  // UART disabled - using RTT only
    log_init();
    timers_init();
    buttons_leds_init(&erase_bonds);
    power_management_init();
    ble_stack_init();
    gap_params_init();
    gatt_init();
    services_init();
    advertising_init();
    conn_params_init();

    // Start execution.
    printf("\r\nUART started.\r\n");
    NRF_LOG_INFO("Debug logging for UART over RTT started.");
    
    // Now that SoftDevice is initialized, we can safely initialize GPIO pins
    // Initialize 5V enable pin (P0.09)
    nrf_gpio_cfg_output(9);
    nrf_gpio_pin_set(9);  // Set HIGH to enable 5V power
    NRF_LOG_INFO("5V enable pin (P0.09) set HIGH");
    NRF_LOG_FLUSH();
    
    // Initialize PWM for LED matrix and send all zeros to turn off LEDs
    // PWM initialization may send default signals, so we immediately send zeros
    matrix_spi_init();  // This will automatically send zeros to turn off all LEDs
    NRF_LOG_INFO("LED matrix PWM initialized and all LEDs set to OFF");
    NRF_LOG_FLUSH();
    
    // Test function commented out - only initialization (zeros) is sent
    // matrix_test_single_led(0, 10, 0);
    
    ret_code_t err_code = app_timer_start(m_led_update_timer_id,
                                           APP_TIMER_TICKS(LED_UPDATE_INTERVAL_MS),
                                           NULL);
    APP_ERROR_CHECK(err_code);
    NRF_LOG_INFO("LED matrix update timer started (%d ms interval)", LED_UPDATE_INTERVAL_MS);
    NRF_LOG_FLUSH();

    err_code = app_timer_start(m_ble_send_count_timer_id,
                               APP_TIMER_TICKS(BLE_SEND_COUNT_INTERVAL_MS),
                               NULL);
    APP_ERROR_CHECK(err_code);
    NRF_LOG_INFO("BLE count send timer started (%d ms interval)", BLE_SEND_COUNT_INTERVAL_MS);
    NRF_LOG_FLUSH();

    advertising_start();

    // Enter main loop.
    for (;;)
    {
        idle_state_handle();
    }
}


/**
 * @}
 */
