ttkpark/BLE_LED_Dongle/firmware/custom_board.h

/**
 * Custom board definition to avoid GPIO pin conflicts.
 * LED matrix uses pin 6, so BSP LEDs are moved to pins 21-24.
 */

#ifndef CUSTOM_BOARD_H
#define CUSTOM_BOARD_H

#ifdef __cplusplus
extern "C" {
#endif

#include "nrf_gpio.h"

// LEDs definitions - moved from 17-20 to 21-24 to avoid conflict with LED matrix pin 6
#define LEDS_NUMBER    4

#define LED_START      21
#define LED_1          21
#define LED_2          22
#define LED_3          23
#define LED_4          24
#define LED_STOP       24

#define LEDS_ACTIVE_STATE 0

#define LEDS_INV_MASK  LEDS_MASK

#define LEDS_LIST { LED_1, LED_2, LED_3, LED_4 }

#define BSP_LED_0      LED_1
#define BSP_LED_1      LED_2
#define BSP_LED_2      LED_3
#define BSP_LED_3      LED_4

// Buttons - keep original pins 13-16
#define BUTTONS_NUMBER 4

#define BUTTON_START   13
#define BUTTON_1       13
#define BUTTON_2       14
#define BUTTON_3       15
#define BUTTON_4       16
#define BUTTON_STOP    16
#define BUTTON_PULL    NRF_GPIO_PIN_PULLUP

#define BUTTONS_ACTIVE_STATE 0

#define BUTTONS_LIST { BUTTON_1, BUTTON_2, BUTTON_3, BUTTON_4 }

#define BSP_BUTTON_0   BUTTON_1
#define BSP_BUTTON_1   BUTTON_2
#define BSP_BUTTON_2   BUTTON_3
#define BSP_BUTTON_3   BUTTON_4

// UART pins - keep original
#define RX_PIN_NUMBER  8
#define TX_PIN_NUMBER  6
#define CTS_PIN_NUMBER 7
#define RTS_PIN_NUMBER 5
#define HWFC           true

#ifdef __cplusplus
}
#endif

#endif // CUSTOM_BOARD_H
