ttkpark/BLE_LED_Dongle/(commit log)

2026-02-12 Save current state: SoftDevice priority-based LED matrix with bit-banging
2026-02-12 Implement PWM EasyDMA for WS2812 LED matrix control
    - Changed from SPI to PWM EasyDMA (nRF52810 doesn't support SPIM)
    - PWM configuration: 16MHz base clock, top value 20 (800ns per bit)
    - WS2812 bit encoding: '0' = 6 cycles, '1' = 12 cycles
    - PWM EasyDMA automatically sends data without CPU intervention
    - No interrupt disabling needed - works seamlessly with SoftDevice
    - Updated led_matrix.c to use nrfx_pwm driver
    - Updated sdk_config.h: NRFX_PWM_ENABLED=1, NRFX_PWM0_ENABLED=1
    - Added nrfx_pwm.c to project
    - Fixed PWM instance initialization (runtime instead of static)
    [led_matrix.c, led_matrix.h, main.c, sdk_config.h]
2026-02-13 Fix PWM timing and disable matrix updates
    - Adjusted WS2812 PWM timing values (Bit '0': 5 cycles, Bit '1': 10 cycles)
    - Restored PWM inversion for WS2812 compatibility
    - Added PWM stop and uninit after sending zeros to prevent default signals
    - Set LED matrix pin to GPIO LOW after PWM shutdown
    - Disabled periodic LED matrix updates (single update at boot only)
    - Fixed SPI references to PWM in comments
    - Added matrix_test_single_led() function for debugging
    - Fixed PWM_ENABLED and PWM0_ENABLED in sdk_config.h (was 0, now 1)
    - Fixed NRFX_PWM_ENABLED to use #undef instead of #ifndef to override defaults
    [led_matrix.c, led_matrix.h, main.c, sdk_config.h]
2026-02-13 process: PWM DMA using WS2812B
2026-02-14 Revert "ㅏㅏㅏ"
    This reverts commit 1bd51dec3e707f2df3d4e5aa9b9953b51173f20c.
    [BLE_LED_Dongle.kicad_sch]
